Saco-de-patatas/W1209-PY/Schematic/Display.jpg

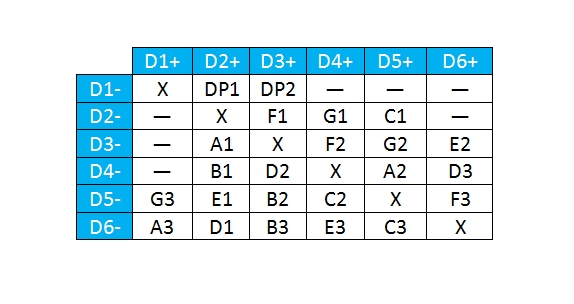
Schematic/Display.jpg
