Saco-de-patatas/W1209-PY/Schematic/W1209-PY.sch

## KiCad design Schematic/W1209-PY.sch (2025-09-22)

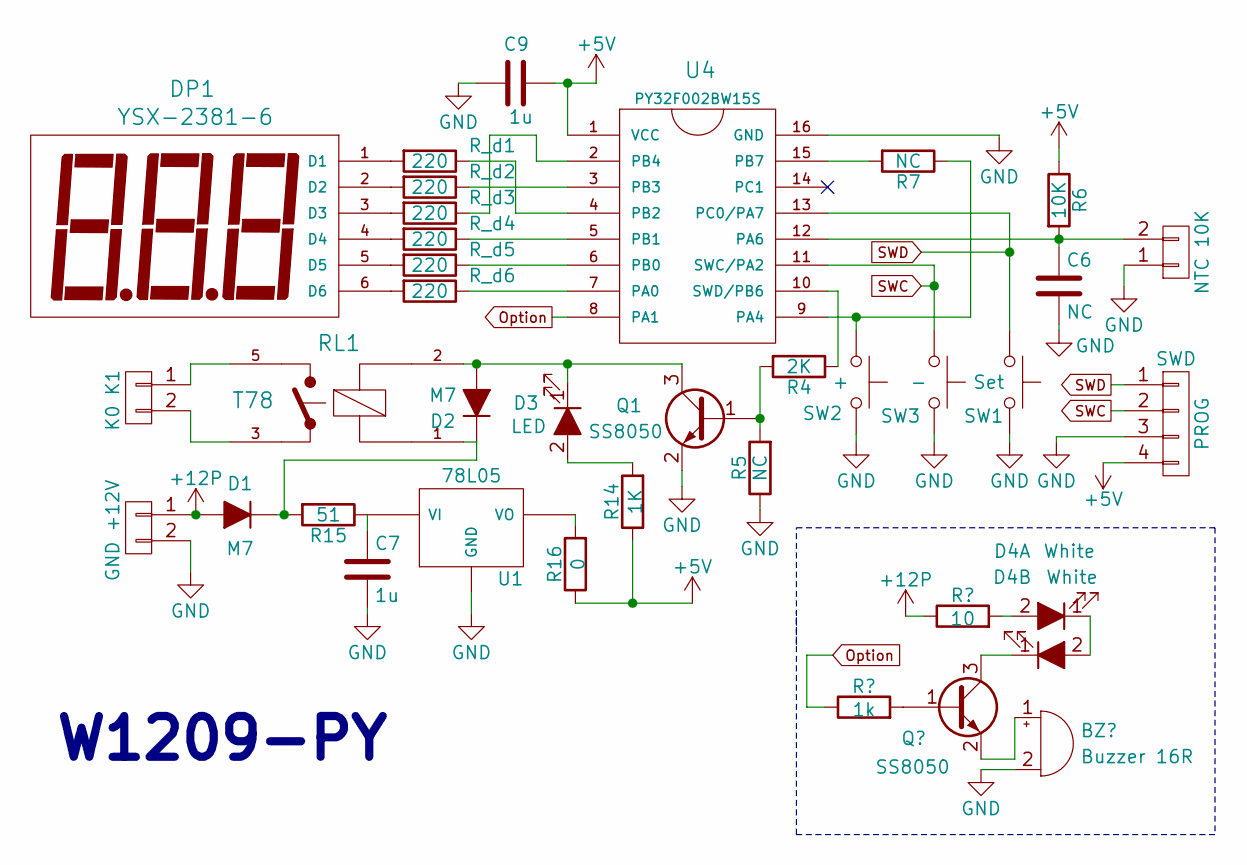
[picture p3: schematic W1209-PY.sch]

Parts:
C6: NC
C7, C9: 1u
D1, D2: M7
D3: LED
D4A, D4B: White
DP1: YSX-2381-6
Q1: SS8050
R4: 2K
R5, R7: NC
R6: 10K
R14: 1K
R15: 51
R16: 0
RL1: T78
R_d1, R_d2, R_d3, R_d4, R_d5, R_d6: 220
SW1: Set
SW2: +
SW3: -
SWD: PROG
U1: 78L05
U4: PY32F002BW15S

Connections:
+5V: C9.1, R6.1, R14.1, R16.1, SWD.4, U4.1 (VCC)
+12P: D1.2 (A)
GND: C6.2, C7.2, C9.2, Q1.2 (E), R5.1, SW1.2, SW2.2, SW3.2, SWD.3, U1.GND, U4.16 (GND)
unnamed: C6.1, R6.2, U4.12 (PA6)
unnamed: C7.1, R15.1, U1.VI
unnamed: D1.1 (K), D2.1 (K), R15.2, RL1.1
unnamed: D2.2 (A), D3.1 (K), Q1.3 (C), RL1.2
unnamed: D3.2 (A), R14.2
unnamed: D4A.1 (K), D4B.2 (A)
unnamed: DP1.1 (D1), R_d1.2
unnamed: DP1.2 (D2), R_d2.2
unnamed: DP1.3 (D3), R_d3.2
unnamed: DP1.4 (D4), R_d4.2
unnamed: DP1.5 (D5), R_d5.2
unnamed: DP1.6 (D6), R_d6.2
unnamed: Q1.1 (B), R4.2, R5.2
unnamed: R4.1, U4.10 (SWD/PB6)
unnamed: R7.1, SW2.1, U4.9 (PA4)
unnamed: R7.2, U4.15 (PB7)
unnamed: R16.2, U1.VO
unnamed: R_d1.1, U4.4 (PB2)
unnamed: R_d2.1, U4.3 (PB3)
unnamed: R_d3.1, U4.2 (PB4)
unnamed: R_d4.1, U4.5 (PB1)
unnamed: R_d5.1, U4.6 (PB0)
unnamed: R_d6.1, U4.7 (PA0)
Option: U4.8 (PA1)
SWC: SW3.1, SWD.2, U4.11 (SWC/PA2)
SWD: SW1.1, SWD.1, U4.13 (PC0/PA7)

Notes on the sheet:
W1209-PY
